jeanpassos2/PlanoInclinadoMakerLab/imagens eletrônica/esquematico_cabos.png

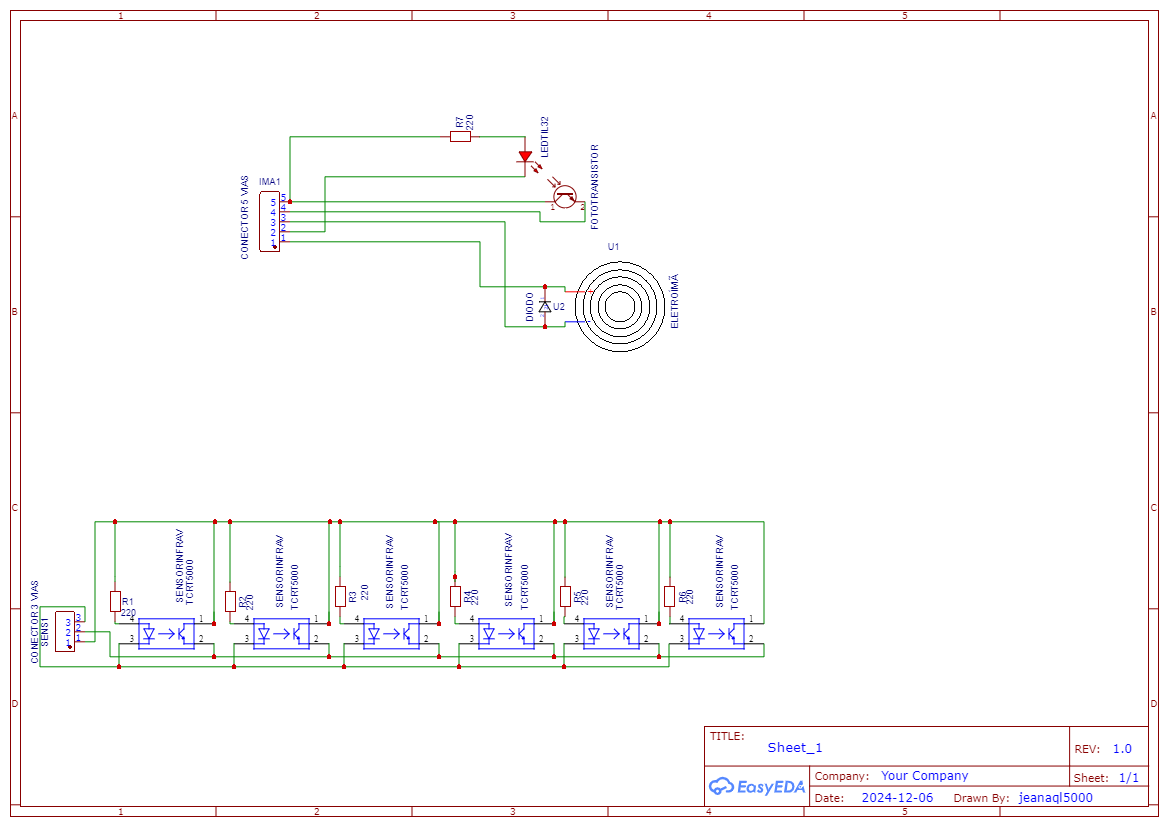
imagens eletrônica/esquematico_cabos.png
