jeanpassos2/PlanoInclinadoMakerLab/imagens eletrônica/PCB.png

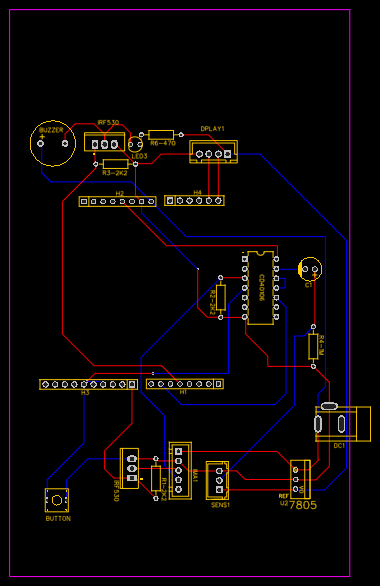
imagens eletrônica/PCB.png
