jeanpassos2/PlanoInclinadoMakerLab/imagens eletrônica/pcb_3D.jpg

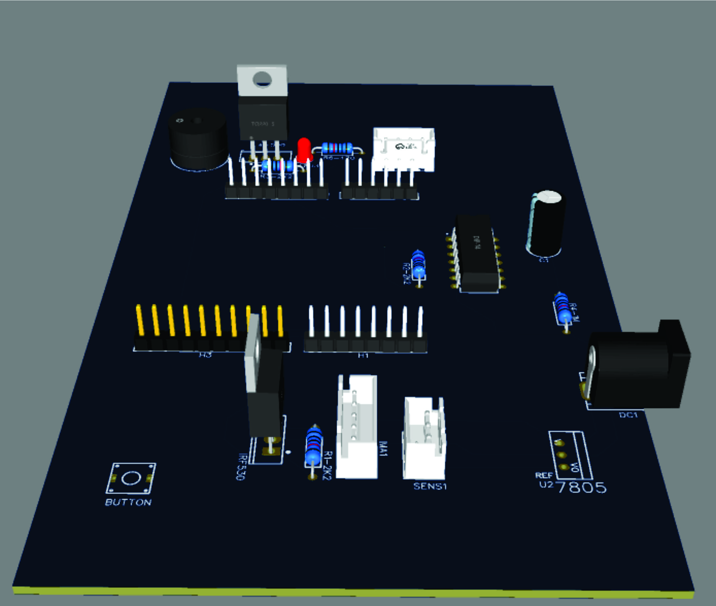
imagens eletrônica/pcb_3D.jpg
