jeanpassos2/PlanoInclinadoMakerLab/arquivos da estrutura/tampa_case_placa_eletronica.stl

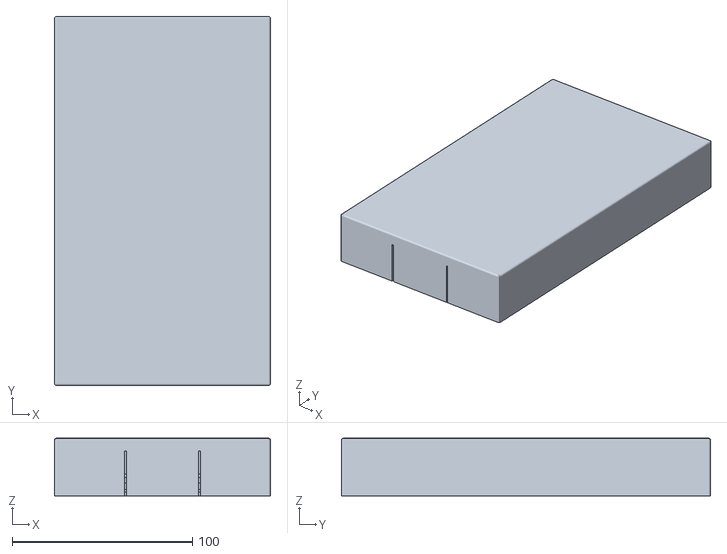
[picture p4: CAD file, 2024-12-12]
arquivos da estrutura/tampa_case_placa_eletronica.stl
120.0 x 205.0 x 32.0
