jeanpassos2/PlanoInclinadoMakerLab/arquivos da estrutura/tampa_da_base.stl

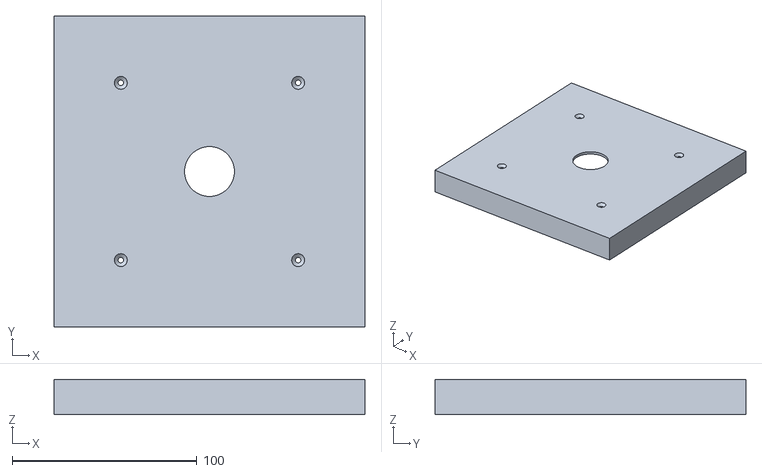
[picture p5: CAD file, 2024-12-12]
arquivos da estrutura/tampa_da_base.stl
168.4 x 168.4 x 19.0
