jeanpassos2/PlanoInclinadoMakerLab/arquivos da estrutura/suporte_base.stl

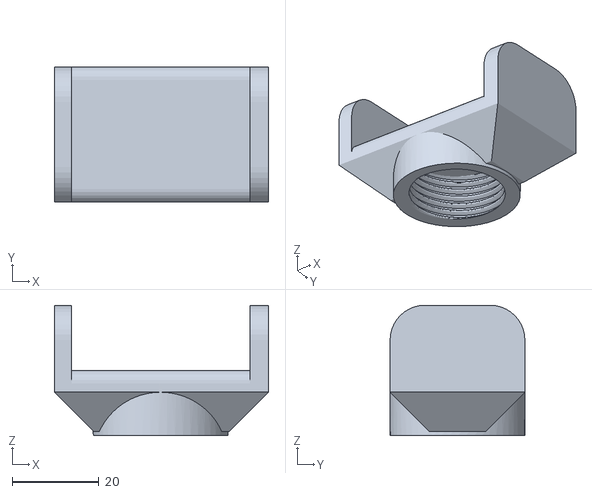
[picture p6: CAD file, 2024-12-12]
arquivos da estrutura/suporte_base.stl
49.2 x 31.0 x 30.0
