jeanpassos2/PlanoInclinadoMakerLab/arquivos da estrutura/caixa_dos_sensores.stl

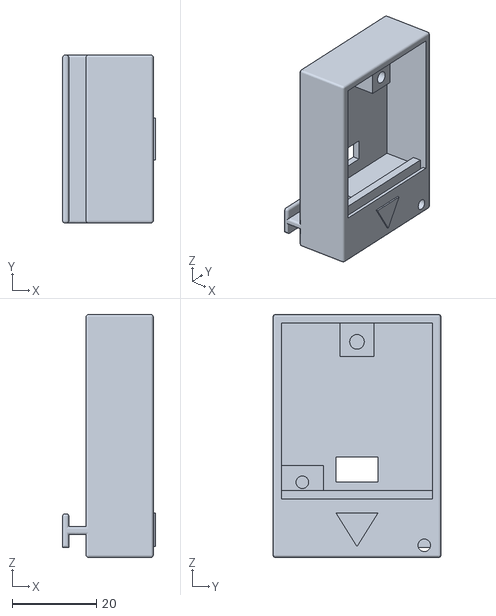
[picture p7: CAD file, 2024-12-12]
arquivos da estrutura/caixa_dos_sensores.stl
22.1 x 40.0 x 57.8
