jeanpassos2/PlanoInclinadoMakerLab/arquivos da estrutura/segmento_296mm.stl

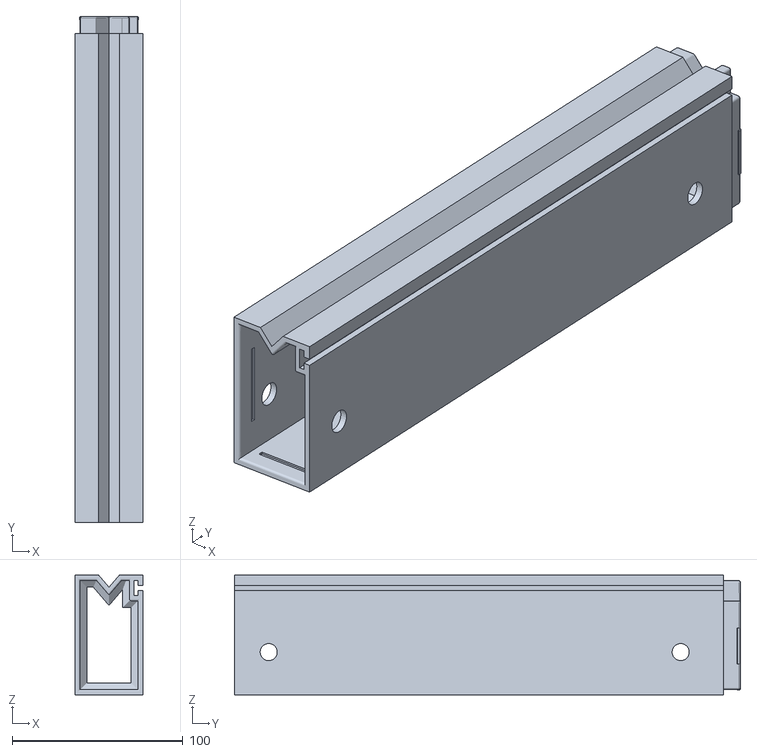
[picture p8: CAD file, 2024-12-12]
arquivos da estrutura/segmento_296mm.stl
40.0 x 296.0 x 70.0
