jeanpassos2/PlanoInclinadoMakerLab/arquivos da estrutura/ponteira_fim.stl

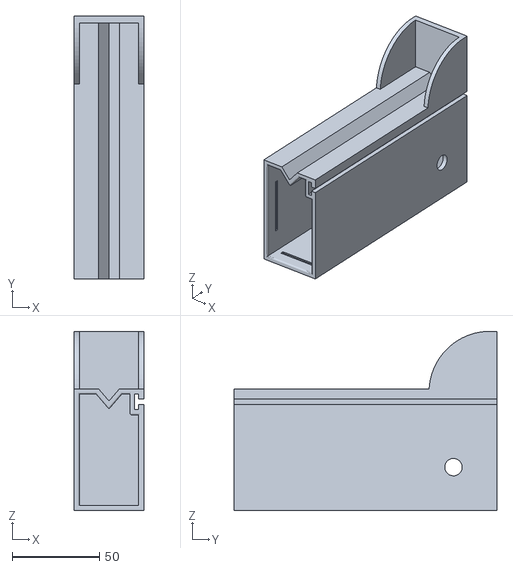
[picture p9: CAD file, 2024-12-12]
arquivos da estrutura/ponteira_fim.stl
40.0 x 151.0 x 103.0
