jeanpassos2/PlanoInclinadoMakerLab/arquivos da estrutura/fundo_da_base.stl

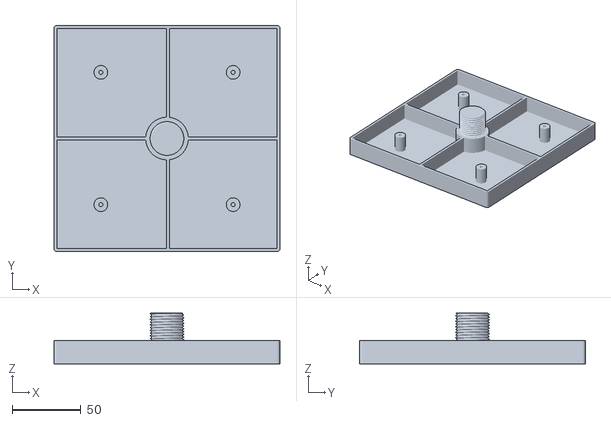
[picture p10: CAD file, 2024-12-12]
arquivos da estrutura/fundo_da_base.stl
164.0 x 164.0 x 37.0
