jeanpassos2/PlanoInclinadoMakerLab/arquivos da estrutura/haste_base.stl

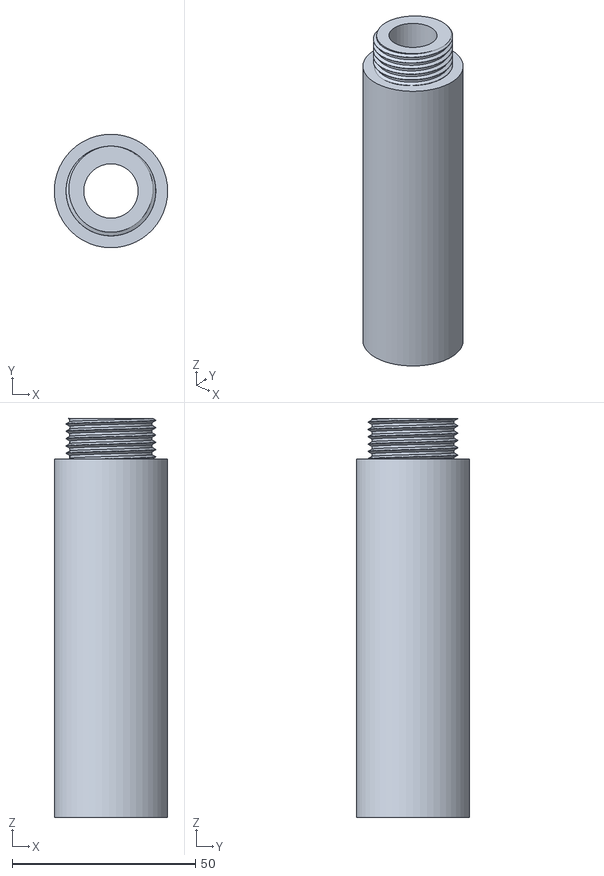
[picture p11: CAD file, 2024-12-12]
arquivos da estrutura/haste_base.stl
31.0 x 31.0 x 109.0
