jeanpassos2/PlanoInclinadoMakerLab/arquivos da estrutura/tampa_ponteira_inicio.stl

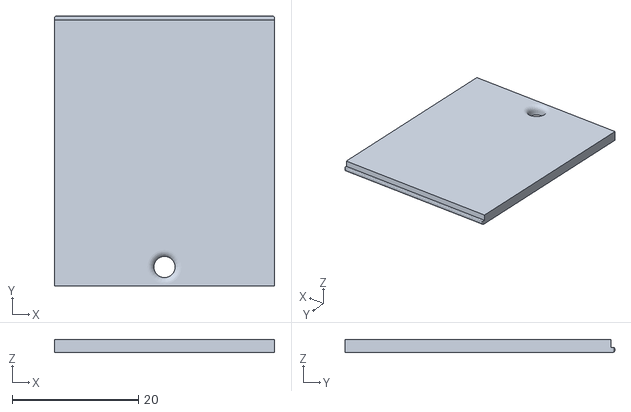
[picture p12: CAD file, 2024-12-12]
arquivos da estrutura/tampa_ponteira_inicio.stl
34.9 x 42.8 x 2.00
