jeanpassos2/PlanoInclinadoMakerLab/arquivos da estrutura/tampa_da_caixa_dos_sensores.stl

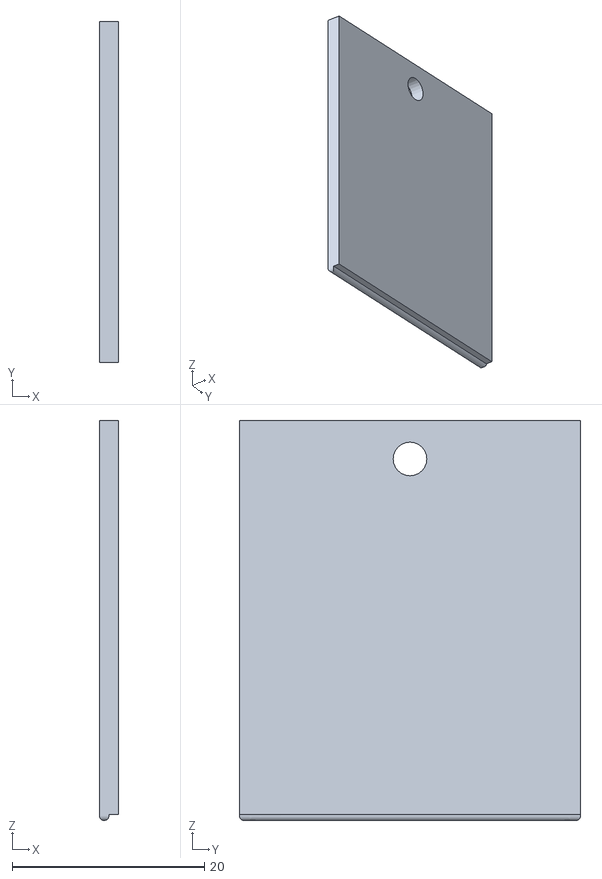
[picture p13: CAD file, 2024-12-12]
arquivos da estrutura/tampa_da_caixa_dos_sensores.stl
2.00 x 35.5 x 41.6
