jeanpassos2/PlanoInclinadoMakerLab/arquivos da estrutura/arruela_base.stl

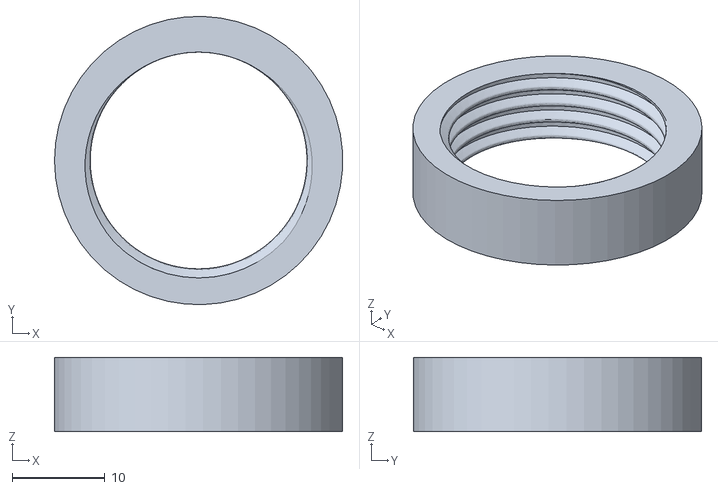
[picture p14: CAD file, 2024-12-12]
arquivos da estrutura/arruela_base.stl
31.0 x 31.0 x 8.00
