jeanpassos2/PlanoInclinadoMakerLab/arquivos da estrutura/trava_fio_ponteira_inico.stl

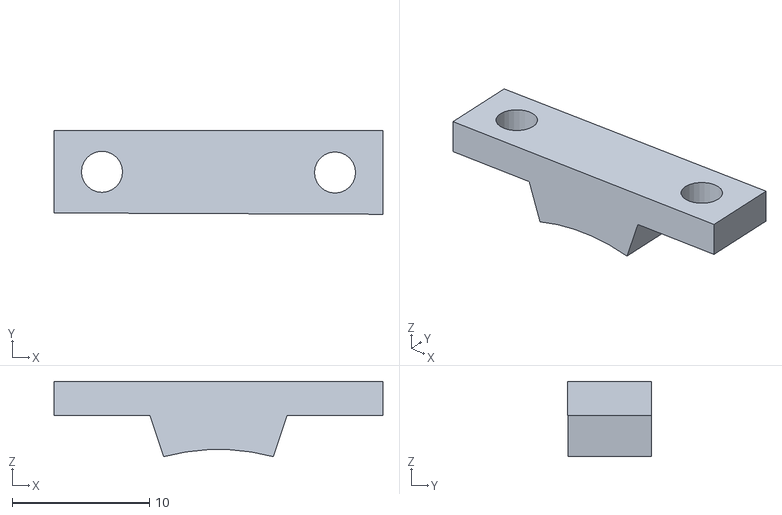
[picture p15: CAD file, 2024-12-12]
arquivos da estrutura/trava_fio_ponteira_inico.stl
24.0 x 6.10 x 5.50
