jeanpassos2/PlanoInclinadoMakerLab/arquivos da estrutura/ponteira_inicio.stl

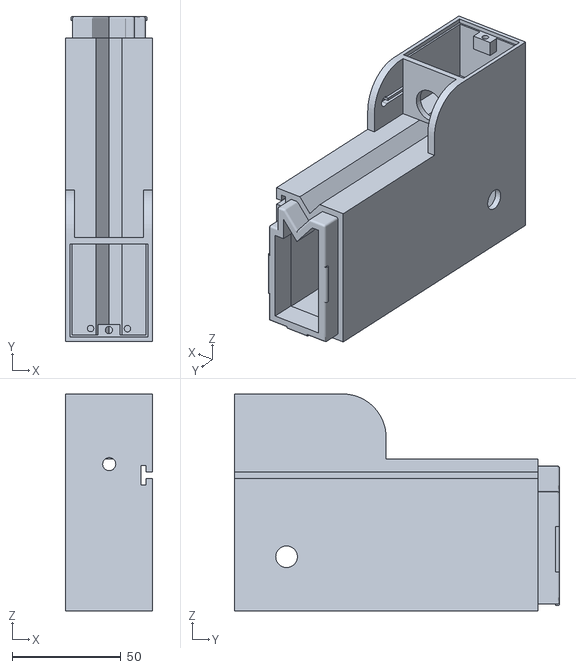
[picture p16: CAD file, 2024-12-12]
arquivos da estrutura/ponteira_inicio.stl
40.0 x 150.0 x 100.0
