jeanpassos2/PlanoInclinadoMakerLab/arquivos da estrutura/case_placa_eletronica.stl

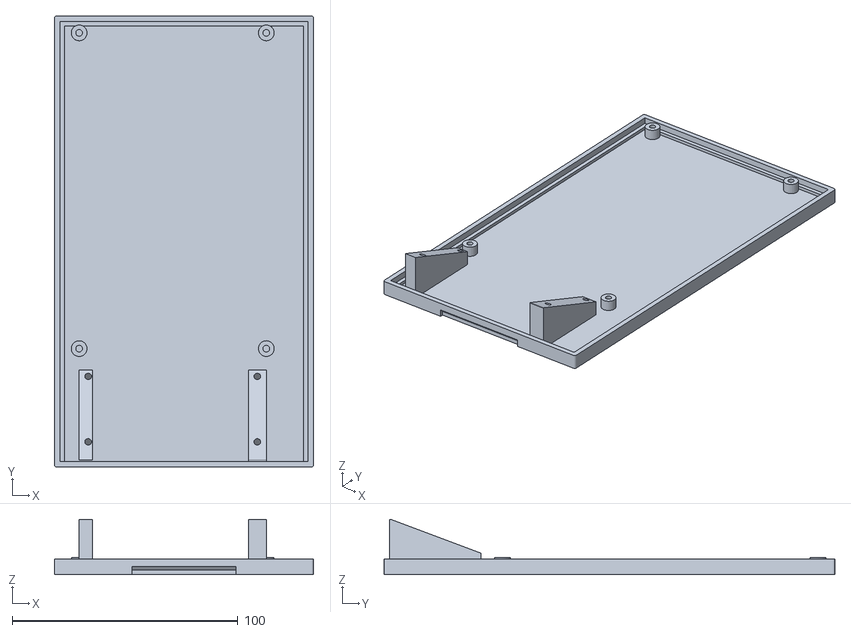
[picture p17: CAD file, 2024-12-12]
arquivos da estrutura/case_placa_eletronica.stl
115.0 x 200.0 x 24.5
