jeanpassos2/PlanoInclinadoMakerLab/arquivos da estrutura/segmento_245mm.stl

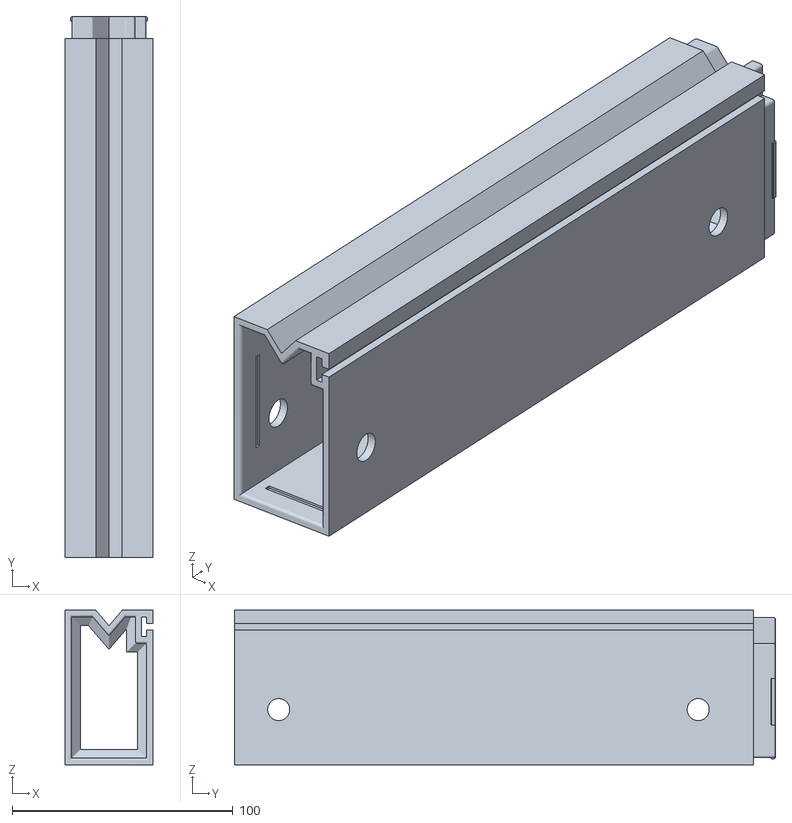
[picture p18: CAD file, 2024-12-12]
arquivos da estrutura/segmento_245mm.stl
40.0 x 245.0 x 70.0
