jeanpassos2/PlanoInclinadoMakerLab/arquivos da estrutura/segmento_200mm.stl

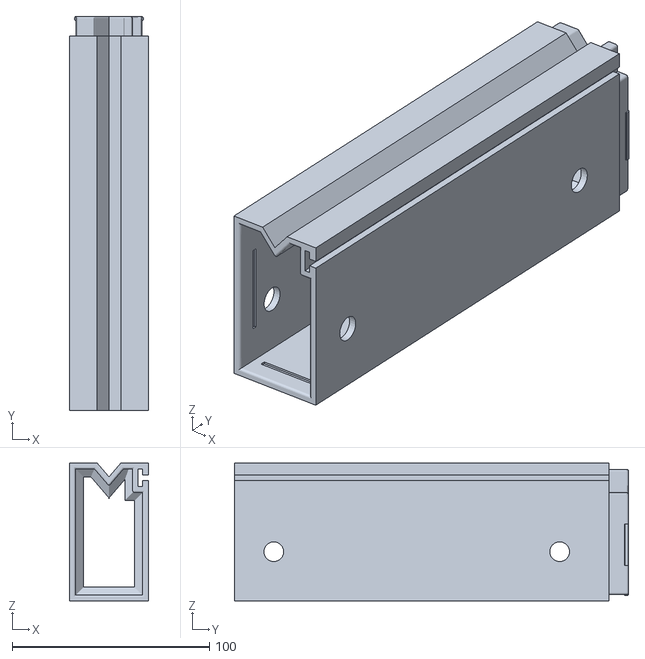
[picture p19: CAD file, 2024-12-12]
arquivos da estrutura/segmento_200mm.stl
40.0 x 200.0 x 70.0
