jeanpassos2/PlanoInclinadoMakerLab/imagens eletrônica/esquematico_cabos.pdf

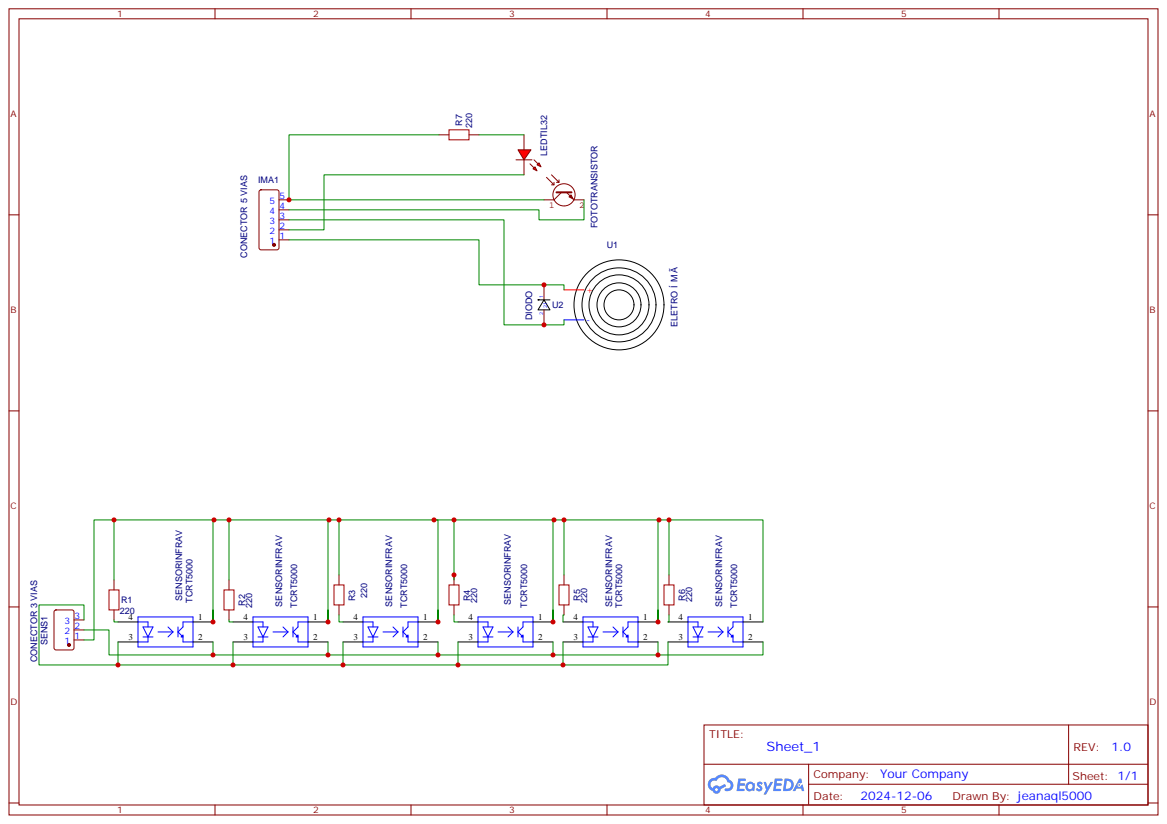
[picture p35: page 1]
