jeanpassos2/PlanoInclinadoMakerLab/imagens eletrônica/PCB.pdf

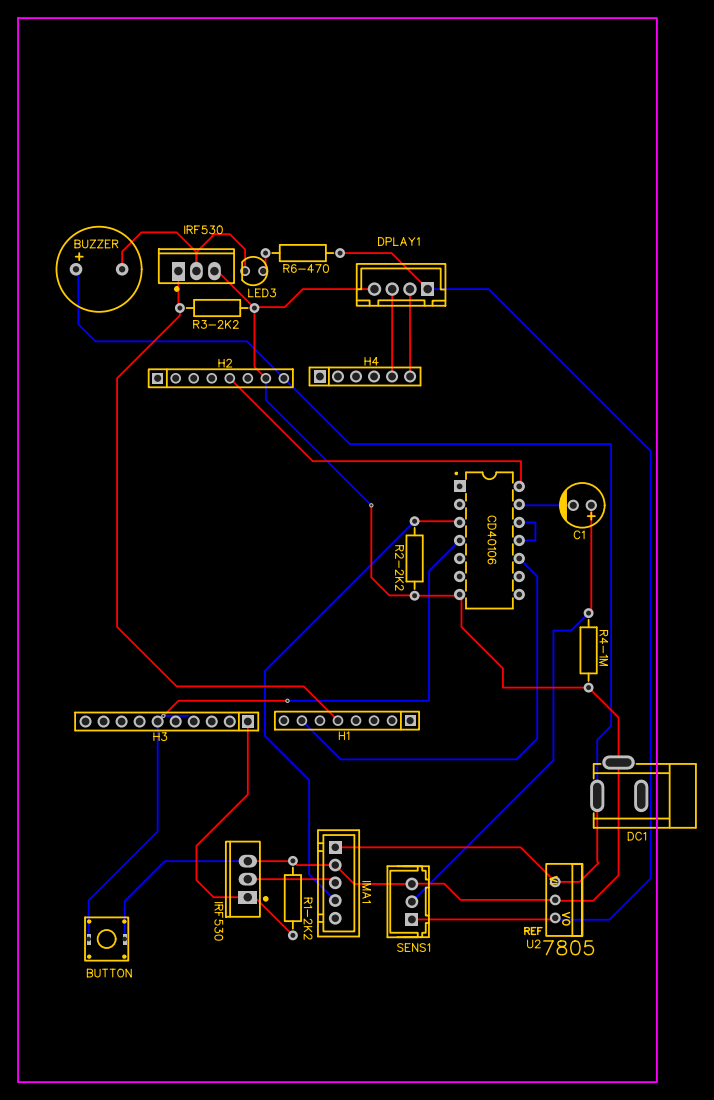
[picture p36: page 1]
