jeanpassos2/PlanoInclinadoMakerLab/(commit log)

2024-12-12 Create segmento_200mm.stl
    Segmento 200
    [segmento_200mm.stl]
2024-12-12 inclui arquivos da estrutura
    inclui os arquivos da estrutura
    [arruela_base.stl, caixa_dos_sensores.stl, case_placa_eletronica.stl, fundo_da_base.stl, haste_base.stl, ponteira_fim.stl, ponteira_inicio.stl, segmento_245mm.stl]
2024-12-12 nome pasta
    [arruela_base.stl, caixa_dos_sensores.stl, case_placa_eletronica.stl, fundo_da_base.stl, haste_base.stl, ponteira_fim.stl, ponteira_inicio.stl, segmento_200mm.stl]
